conductive-brain/PCB/ORX_Lite_Receiver/docs/design_process.md

# Design process

How ORX-LITE was designed: from what it must do, to every value on the schematic.
Every number comes from `calc/design_calcs.py` (output in `calc/results.txt`), unless it says
"datasheet" or "choice". Each formula has its LibreOffice StarMath code under it.

## 1. What the board must do

| Need | Value | Source |
|---|---|---|
| Light input | one photodiode, 320 to 1060 nm | choice; S5971 datasheet |
| Signal speed | about 100 kHz | choice |
| Sampling | 12 bits, 1 million samples per second | choice |
| Interface | SPI, 3 wires, 3.3 V logic, to any microcontroller board | choice |
| Power | 5 V and 3.3 V from the microcontroller board | choice |
| Board | 4 layers, about 50 x 40 mm | choice |

## 2. The chain

```
light → photodiode → TIA → low-pass filter → R8 + C16 → ADC → J1 → microcontroller
        (current)    (voltage)  (clean voltage)            (numbers)
```

- The photodiode makes a current that follows the light.
- The TIA turns the current into a voltage.
- The filter removes everything faster than the ADC can handle.
- R8 and C16 feed the ADC's sampling capacitor.
- The ADC turns the voltage into numbers and sends them over SPI.

The full schematic is in
[release/rev-A/docs/ORX-LITE one-channel optical receiver.pdf](../release/rev-A/docs/ORX-LITE%20one-channel%20optical%20receiver.pdf).

## 3. Power

```
J1 5 V   → FB1 → +5V_F → U1 → +3V3_A   → op amps U3, U4
                       → U2 → +3V0_ADC → ADC supply and reference, VREF divider
                       → R2 → PD_K     → photodiode bias
J1 3.3 V → FB2 → +3V3_D → ADC digital side, LED, CS pull-up
```

**Why linear regulators.** A switching regulator makes ripple at its switching frequency, right
where our signal lives. A linear regulator makes no ripple; it only turns the extra voltage into heat.

**Why two regulators.** The ADC uses its supply as its reference, so it gets a quiet supply of its own.
This also keeps the ADC's current pulses off the op amps' supply.

**How much current we take from 5 V** (op amps 5 mA max each, datasheet; ADC 0.23 mA, datasheet;
VREF divider 3.0 V / 12 kΩ):

$$I_{5V} = 2 \cdot 5\,\text{mA} + 0.23\,\text{mA} + \frac{3.0\,\text{V}}{12\,\text{k}\Omega} = 10.5\,\text{mA}$$

```
I_{5V} = 2 cdot 5 " mA" + 0.23 " mA" + {3.0 " V"} over {12 " k" %OMEGA} = 10.5 " mA"
```

**How hot U1 gets.** Small, so no cooling needed:

$$P_{U1} = (5.0 - 3.3)\,\text{V} \times 10\,\text{mA} = 17\,\text{mW}$$

```
P_{U1} = (5.0 - 3.3) " V" times 10 " mA" = 17 " mW"
```

**LED current** (2.0 V green LED drop is an assumption):

$$I_{LED} = \frac{3.3\,\text{V} - 2.0\,\text{V}}{1\,\text{k}\Omega} = 1.3\,\text{mA}$$

```
I_{LED} = {3.3 " V" - 2.0 " V"} over {1 " k" %OMEGA} = 1.3 " mA"
```

## 4. Photodiode bias

A photodiode with a positive voltage on its cathode (reverse bias) is faster and more linear.
Our only voltage above 3.3 V is the 5 V from the host, so the cathode gets filtered 5 V.

$$f_{bias} = \frac{1}{2\pi R_2 C_7} = \frac{1}{2\pi \cdot 1\,\text{k}\Omega \cdot 10\,\mu\text{F}} = 16\,\text{Hz}$$

```
f_{bias} = 1 over {2 %pi R_2 C_7} = 1 over {2 %pi cdot 1 " k" %OMEGA cdot 10 " %mu F"} = 16 " Hz"
```

The anode sits at VREF_TIA = 2.5 V (section 5), so:

$$V_{bias} = 5.0\,\text{V} - 2.5\,\text{V} = 2.5\,\text{V}$$

```
V_{bias} = 5.0 " V" - 2.5 " V" = 2.5 " V"
```

At 2.5 V the S5971 has about 7.5 pF (read from the datasheet graph). At 10 V it would have 3 pF.
For a 100 kHz signal, 7.5 pF is fine.

## 5. TIA: current to voltage

The op amp keeps its − input at the same voltage as its + input (2.5 V). The photocurrent cannot
flow into the op amp's input (only 0.2 pA flows there, datasheet). So all of it flows through R3:

$$V_{TIA} = V_{REF} - I_{ph} \cdot R_3$$

```
V_{TIA} = V_{REF} - I_{ph} cdot R_3
```

Examples: no light gives 2.5 V. 10 µA gives 2.5 V − 10 µA × 100 kΩ = 1.5 V.

**The 2.5 V reference.** The output can only go down with light, so it starts high:

$$V_{REF} = 3.0\,\text{V} \cdot \frac{R_5}{R_4 + R_5} = 3.0\,\text{V} \cdot \frac{10\,\text{k}}{12\,\text{k}} = 2.5\,\text{V}$$

```
V_{REF} = 3.0 " V" cdot {R_5} over {R_4 + R_5} = 3.0 " V" cdot {10 " k"} over {12 " k"} = 2.5 " V"
```

It comes from +3V0_ADC, the ADC's own reference. If that rail is 2 % high, VREF and the ADC's range
are both 2 % high, and the dark reading stays the same (a "ratiometric" design).
C11 filters the reference:

$$f_{ref} = \frac{1}{2\pi \frac{R_4 R_5}{R_4 + R_5} C_{11}} = \frac{1}{2\pi \cdot 1.67\,\text{k}\Omega \cdot 10\,\mu\text{F}} = 9.5\,\text{Hz}$$

```
f_{ref} = 1 over {2 %pi {R_4 R_5} over {R_4 + R_5} C_{11}} = 1 over {2 %pi cdot 1.67 " k" %OMEGA cdot 10 " %mu F"} = 9.5 " Hz"
```

**Choosing R3 (the gain).** The output can go from 2.5 V down to about 0.05 V (the OPA365 gets
within 20 mV of its rail, datasheet; 0.05 V is our margin). R3 = 100 kΩ gives:

$$I_{FS} = \frac{V_{REF} - 0.05\,\text{V}}{R_3} = \frac{2.45\,\text{V}}{100\,\text{k}\Omega} = 24.5\,\mu\text{A}$$

```
I_{FS} = {V_{REF} - 0.05 " V"} over R_3 = {2.45 " V"} over {100 " k" %OMEGA} = 24.5 " %mu A"
```

$$P_{FS} = \frac{I_{FS}}{0.60\,\text{A/W}} = 41\,\mu\text{W at 830 nm}$$

```
P_{FS} = I_{FS} over {0.60 " A/W"} = 41 " %mu W"
```

A bigger R3 would see weaker light but would run out of range sooner and be slower.

**Choosing C10 (the speed).** C10 and R3 set the TIA's bandwidth:

$$f_p = \frac{1}{2\pi R_3 C_{10}} = \frac{1}{2\pi \cdot 100\,\text{k}\Omega \cdot 10\,\text{pF}} = 159\,\text{kHz}$$

```
f_p = 1 over {2 %pi R_3 C_{10}} = 1 over {2 %pi cdot 100 " k" %OMEGA cdot 10 " pF"} = 159 " kHz"
```

C10 also keeps the TIA stable. The capacitance at the − input (photodiode, op-amp input, pads)
can make the amplifier ring. That capacitance is:

$$C_{in} = C_d + C_{cm} + C_{diff} + C_{pcb} = 7.5 + 2 + 6 + 0.5 = 16\,\text{pF}$$

```
C_{in} = C_d + C_{cm} + C_{diff} + C_{pcb} = 7.5 + 2 + 6 + 0.5 = 16 " pF"
```

(op-amp input capacitance: datasheet; 0.5 pF for pads: assumption). The smallest C10 that keeps
the TIA stable is:

$$C_{10,min} = \sqrt{\frac{C_{in}}{2\pi R_3 \cdot GBW}} = \sqrt{\frac{16\,\text{pF}}{2\pi \cdot 100\,\text{k}\Omega \cdot 50\,\text{MHz}}} = 0.71\,\text{pF}$$

```
C_{10,min} = sqrt{ C_{in} over {2 %pi R_3 cdot GBW} } = sqrt{ {16 " pF"} over {2 %pi cdot 100 " k" %OMEGA cdot 50 " MHz"} } = 0.71 " pF"
```

10 pF is far above that: the phase margin is 84° (model; above 45° counts as stable). We use the
larger value on purpose: it limits the bandwidth to what we need, and less bandwidth means less noise.

## 6. Low-pass filter

The ADC samples 1 million times per second. Anything faster than half of that (500 kHz) folds back
and looks like a slow signal. This is called aliasing. The filter removes it before the ADC sees it.

The filter is a 2nd-order Sallen-Key with R6 = R7 = R:

$$f_0 = \frac{1}{2\pi R \sqrt{C_{13} C_{14}}} = \frac{1}{2\pi \cdot 4.99\,\text{k}\Omega \cdot \sqrt{220\,\text{pF} \cdot 100\,\text{pF}}} = 215\,\text{kHz}$$

```
f_0 = 1 over {2 %pi R sqrt{C_{13} C_{14}}} = 1 over {2 %pi cdot 4.99 " k" %OMEGA cdot sqrt{220 " pF" cdot 100 " pF"}} = 215 " kHz"
```

$$Q = \frac{1}{2}\sqrt{\frac{C_{13}}{C_{14}}} = \frac{1}{2}\sqrt{\frac{220}{100}} = 0.74$$

```
Q = 1 over 2 sqrt{ C_{13} over C_{14} } = 1 over 2 sqrt{ 220 over 100 } = 0.74
```

Q = 0.707 is the flattest response; 0.74 is within 0.04 dB of flat. We use E12 values (220 pF, 100 pF).

**The whole chain** (TIA, filter, R8 + C16) is flat up to 143 kHz (−3 dB). It is 25 dB down at
500 kHz and 40 dB down at 900 kHz, where signals would fold back into our band.

## 7. Feeding the ADC: R8 and C16

At each sample the ADC connects its 15 pF capacitor (datasheet) to the input. That capacitor takes
some charge and makes a small dip. C16 supplies the charge. The datasheet's rule:

$$C_{16} \ge 20 \cdot C_{sample} = 20 \cdot 15\,\text{pF} = 300\,\text{pF} \quad \Rightarrow \quad 1.5\,\text{nF}$$

```
C_{16} >= 20 cdot C_{sample} = 20 cdot 15 " pF" = 300 " pF"
```

R8 keeps U4 from ringing while it drives C16. The datasheet asks for an op amp fast enough:

$$GBW \ge \frac{4}{2\pi R_8 C_{16}} = \frac{4}{2\pi \cdot 22\,\Omega \cdot 1.5\,\text{nF}} = 19\,\text{MHz}$$

```
GBW >= 4 over {2 %pi R_8 C_{16}} = 4 over {2 %pi cdot 22 %OMEGA cdot 1.5 " nF"} = 19 " MHz"
```

The OPA365 has 50 MHz. TI's own example uses 25 Ω and 1.5 nF.

**Does the dip recover in time?** At 1 MSPS with a 16 MHz clock, the ADC converts for
12.5 clock periods plus 15 ns of setup (datasheet). The time left to take the next sample is:

$$t_{acq} = 1\,\mu\text{s} - (12.5 \cdot 62.5\,\text{ns} + 15\,\text{ns}) = 204\,\text{ns}$$

```
t_{acq} = 1 " %mu s" - (12.5 cdot 62.5 " ns" + 15 " ns") = 204 " ns"
```

The datasheet needs at least 200 ns, so 1 MSPS just fits. The worst dip and what is left of it after
200 ns (R8 × C16 = 33 ns):

$$\Delta V = 3.0\,\text{V} \cdot \frac{15\,\text{pF}}{15\,\text{pF} + 1.5\,\text{nF}} = 29.7\,\text{mV}, \qquad \Delta V \cdot e^{-200\,\text{ns}/33\,\text{ns}} = 69\,\mu\text{V}$$

```
%DELTA V = 3.0 " V" cdot {15 " pF"} over {15 " pF" + 1.5 " nF"} = 29.7 " mV" ~~~~ %DELTA V cdot e^{-200 " ns" / 33 " ns"} = 69 " %mu V"
```

69 µV is below half an LSB (366 µV). This simple estimate assumes U4's output is stiff.
The SPICE simulation (step 5, section 10) includes U4 and agrees: at 1.5 V the dip is 16.1 mV
and 28 µV is left after 200 ns.

## 8. ADC and SPI

- **Input:** AINM to GND, AINP to ADC_IN. The ADC reads 0 to 3.0 V as 0 to 4095.
- **One step (LSB):**

$$LSB = \frac{3.0\,\text{V}}{4096} = 732\,\mu\text{V}$$

```
LSB = {3.0 " V"} over 4096 = 732 " %mu V"
```

- **A frame:** CS goes low, the ADC needs 14 SCLK cycles: two zeros, then 12 data bits, MSB first.
  The first frame after power-up is an offset calibration: hold CS low for at least 16 SCLKs
  (datasheet).
- **33 Ω on SCLK, CS_N, SDO:** fast edges ring on the wires to the host. A small resistor at the end
  that drives each wire softens the edge.
- **R12, 10 kΩ pull-up on CS:** keeps the ADC idle until the host drives CS.
  Costs 0.33 mA while CS is low.

## 9. Noise: how small a light change we can see

The ADC's own noise follows from its SNR (70 dB at 3.0 V, datasheet):

$$v_{ADC} = \frac{3.0\,\text{V}}{2\sqrt{2}} \cdot 10^{-70/20} = 335\,\mu\text{V}_{rms}$$

```
v_{ADC} = {3.0 " V"} over {2 sqrt 2} cdot 10^{-70/20} = 335 " %mu V"_{rms}
```

The front end (R3's noise, op-amp noise, filter resistors) adds 22 µVrms at the ADC input (calc, integrated
to 1 GHz). R3's own noise density is:

$$e_{R3} = \sqrt{4 k T R_3} = 40.7\,\text{nV}/\sqrt{\text{Hz}}$$

```
e_{R3} = sqrt{4 k T R_3} = 40.7 " nV/" sqrt{"Hz"}
```

Noises add as a root sum of squares:

$$v_{tot} = \sqrt{v_{front}^2 + v_{ADC}^2} = \sqrt{22^2 + 335^2}\,\mu\text{V} = 336\,\mu\text{V}_{rms} = 0.46\,\text{LSB}$$

```
v_{tot} = sqrt{v_{front}^2 + v_{ADC}^2} = sqrt{22^2 + 335^2} " %mu V" = 336 " %mu V"_{rms}
```

The ADC sets the noise floor; the front end barely adds to it. Referred back to the light current:

$$i_{min} = \frac{v_{tot}}{R_3} = \frac{336\,\mu\text{V}}{100\,\text{k}\Omega} = 3.4\,\text{nA}_{rms}$$

```
i_{min} = v_{tot} over R_3 = {336 " %mu V"} over {100 " k" %OMEGA} = 3.4 " nA"_{rms}
```

## 10. Simulation results, and what is still to check

**SPICE (step 5).** `ORX_LITE_sim/` holds the front end (TIA with its reference, filter, R8 + C16)
with simulation-only sources, run in KiCad 9 (ngspice):
- the photodiode is a current source (10 µA DC, 10 µA AC) with 7.5 pF across it (S5971 datasheet);
- the supplies are ideal 3.3 V and 3.0 V sources;
- the ADC input is a 15 pF capacitor (ADS7042 datasheet) that a switch connects to ADC_IN for
  204 ns of every 1 µs; a second switch empties it in between, the worst case;
- the op amps use KiCad's built-in single-pole model with the OPA365's 50 MHz gain-bandwidth
  (datasheet). Its gain of 100k and output resistance of 10 Ω are round model values.

| Check | SPICE | Hand calculation (sections 5 to 7) |
|---|---|---|
| VREF_TIA | 2.500 V | 2.5 V |
| TIA_OUT at 10 µA of light | 1.500 V | 2.5 V − 10 µA × 100 kΩ = 1.5 V |
| TIA bandwidth (−3 dB) | 159 kHz | 159 kHz |
| Whole chain bandwidth (−3 dB) | 142 kHz | 143 kHz |
| Whole chain at 500 kHz | −25.1 dB | −25 dB |
| Whole chain at 900 kHz | −40.2 dB | −40 dB |
| Highest gain anywhere (peaking) | −0.0002 dB | none expected (Q = 0.74) |
| Sampling dip, ADC_IN at 1.5 V | 16.1 mV | 14.9 mV (29.7 mV scaled from 3.0 V to 1.5 V) |
| Dip left after 200 ns | 28 µV | must stay below half an LSB, 366 µV |

**The frequency response** (small-signal analysis in KiCad):

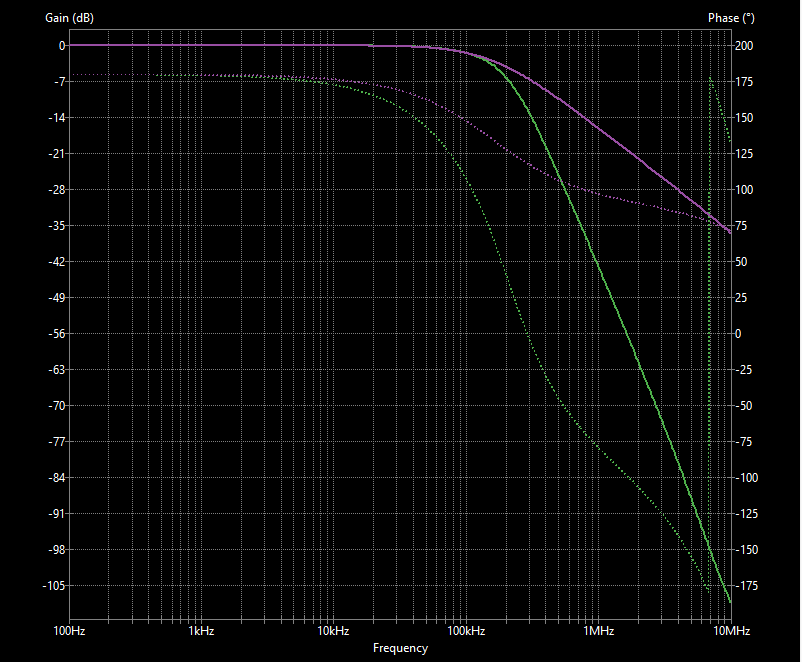
[picture p1: ORX_Lite_Receiver/docs/figures/sim_ac.png]
Gain and phase of TIA_OUT and ADC_IN from 100 Hz to 10 MHz


Purple is TIA_OUT, green is ADC_IN. Solid lines are the gain (left axis, dB), dotted lines the
phase (right axis, degrees). 0 dB is the full TIA gain: the 10 µA AC input × 100 kΩ = 1 V.
- The TIA alone (purple) is flat, 3 dB down at 159 kHz, then falls 20 dB per decade: one pole,
  from R3 and C10.
- The whole chain (green) stays within 0.4 dB up to 50 kHz, is 1.5 dB down at 100 kHz and 3 dB
  down at 142 kHz. Then it falls about 60 dB per decade: the TIA's pole plus the filter's two.
  At 500 kHz, half the sample rate, it is 25 dB down, so fast noise cannot fold back.
- The green line never rises above 0 dB: the filter does not ring.
- The phase starts at 180° because the TIA inverts: more light gives a lower voltage. The jump
  of the green phase near 7 MHz is only the plot wrapping from −180° to +180°.

**The ADC sampling** (transient analysis in KiCad, 20 µs):

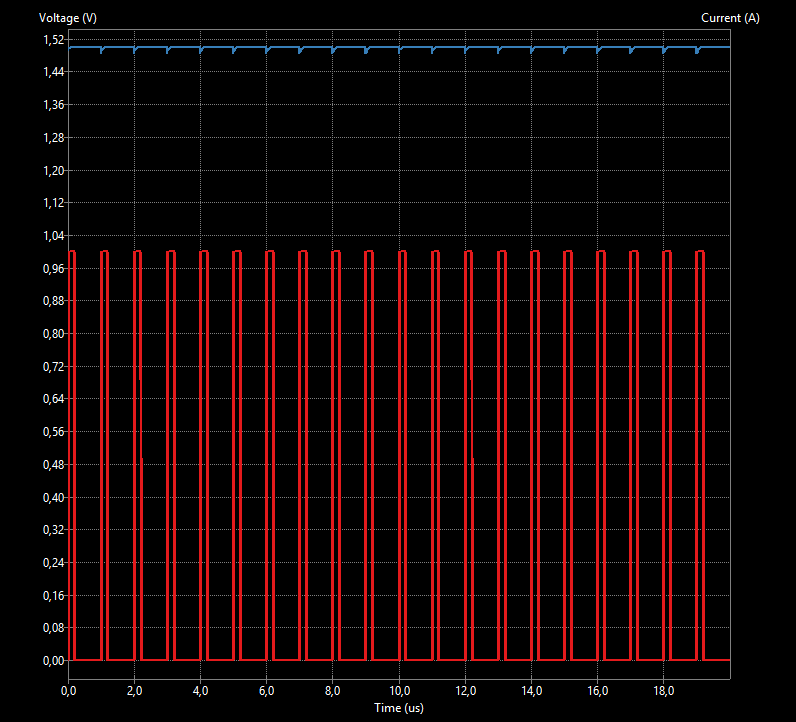
[picture p2: ORX_Lite_Receiver/docs/figures/sim_transient.png]
ACQ pulses and ADC_IN during 20 samples


Red is ACQ: high for 204 ns of every 1 µs, while the ADC's 15 pF is connected to ADC_IN. Blue is
ADC_IN at 1.5 V. At every sample the empty 15 pF takes charge from C16, so ADC_IN drops 16.1 mV
within 1 ns. U4 then refills C16 through R8: 3.3 mV are left after 50 ns, 0.7 mV after 100 ns and
28 µV after 200 ns, before the switch opens at 204 ns. All 20 samples look the same, so nothing
builds up from one sample to the next.

**Two problems on the way, and their fixes:**
- The two switches were first wired the wrong way round: the pulse went into the switch contacts
  and ADC_IN into the control input. The switch symbol has a control side (the "V" circle) and a
  contact side. The pulse drives the control side; the signal goes through the contacts.
- The first 20 µs run seemed to stop at 2.3 µs. Right after the second switch empties the 15 pF,
  the simulator takes steps of a few picoseconds, and with "Save all currents" ticked KiCad puts a
  current meter on every pin, which made the run about 80 times slower (measured). With only
  "Save all voltages" ticked the run finishes in seconds. The values are typed without a decimal
  point (500p, 20u), so the country setting of the PC cannot change them.

Still to check:
- Noise, with TI's own OPA365 model (the built-in model has no op-amp noise).
- The ADC's real sampling switch resistance (the simulation uses an ideal 1 Ω).
- Layout rules, from placement to routing (steps 7 and 8).
