conductive-brain/PCB/ORX_Lite_Receiver/release/rev-A/docs/ORX-LITE_3D_revA.png

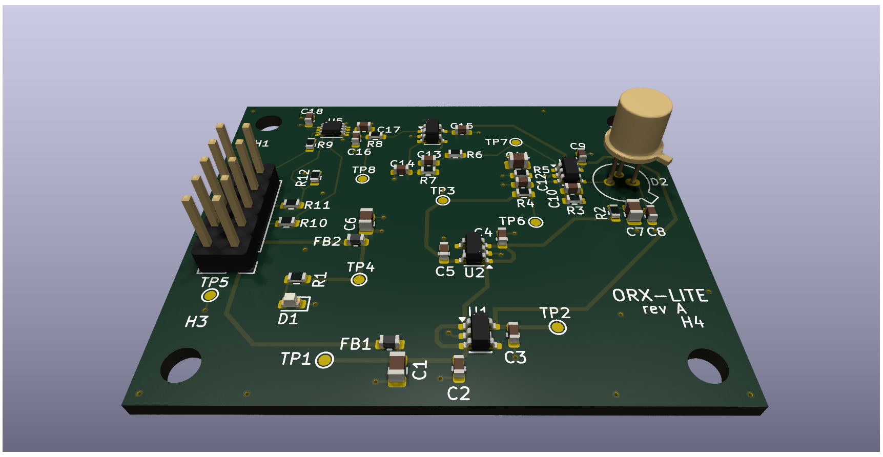
ORX_Lite_Receiver/release/rev-A/docs/ORX-LITE_3D_revA.png
