conductive-brain/PCB/ORX_Lite_Receiver/release/rev-A/assembly/ORX-LITE_BOM_revA.csv

Reference | Value | Datasheet | Footprint | Qty | DNP
C1,C6,C7,C11 | 10u | ~ | Capacitor_SMD:C_0805_2012Metric | 4
C2,C3,C4,C5,C17,C18 | 1u | ~ | Capacitor_SMD:C_0603_1608Metric | 6
C8,C9,C12,C15 | 100n | ~ | Capacitor_SMD:C_0603_1608Metric | 4
C10 | 10p | ~ | Capacitor_SMD:C_0603_1608Metric | 1
C13 | 220p | ~ | Capacitor_SMD:C_0603_1608Metric | 1
C14 | 100p | ~ | Capacitor_SMD:C_0603_1608Metric | 1
C16 | 1.5n | ~ | Capacitor_SMD:C_0603_1608Metric | 1
D1 | green | ~ | LED_SMD:LED_0603_1608Metric | 1
D2 | S5971 | https://www.hamamatsu.com/resources/pdf/ssd/s5971_etc_kpin1025e.pdf | Package_TO_SOT_THT:TO-18-3 | 1
FB1,FB2 | 220R@100MHz | ~ | Inductor_SMD:L_0603_1608Metric | 2
J1 | Conn_02x05_Odd_Even | ~ | Connector_PinHeader_2.54mm:PinHeader_2x05_P2.54mm_Vertical | 1
R1,R2 | 1k | ~ | Resistor_SMD:R_0603_1608Metric | 2
R3 | 100k | ~ | Resistor_SMD:R_0603_1608Metric | 1
R4 | 2k | ~ | Resistor_SMD:R_0603_1608Metric | 1
R5,R12 | 10k | ~ | Resistor_SMD:R_0603_1608Metric | 2
R6,R7 | 4.99k | ~ | Resistor_SMD:R_0603_1608Metric | 2
R8 | 22 | ~ | Resistor_SMD:R_0603_1608Metric | 1
R9,R10,R11 | 33 | ~ | Resistor_SMD:R_0603_1608Metric | 3
U1 | LP5907MFX-3.3 | http://www.ti.com/lit/ds/symlink/lp5907.pdf | Package_TO_SOT_SMD:SOT-23-5 | 1
U2 | LP5907MFX-3.0 | http://www.ti.com/lit/ds/symlink/lp5907.pdf | Package_TO_SOT_SMD:SOT-23-5 | 1
U3,U4 | OPA365xxDBV | https://www.ti.com/lit/ds/symlink/opa365.pdf | Package_TO_SOT_SMD:SOT-23-5 | 2
U5 | ADS7042xDCU | http://www.ti.com/lit/ds/symlink/ads7042.pdf | Package_SO:VSSOP-8_2.3x2mm_P0.5mm | 1
