conductive-brain/PCB/ORX_Lite_Receiver/calc/results.txt

== Power
5 V current, max                          10.48 mA      2 op amps + ADC AVDD + VREF divider
U1 heat                                      17 mW      (5 - 3.3) V x 10 mA
U2 heat                                    0.96 mW      (5 - 3.0) V x U2 load
LED current                                 1.3 mA      (3.3 - 2.0) V / R1
R12 current when CS is low                 0.33 mA      3.3 V / R12

== Photodiode bias
Bias filter corner                        15.92 Hz      1/(2 pi R2 C7)
Reverse bias                                2.5 V       5 V - VREF_TIA

== TIA
VREF_TIA                                    2.5 V       3.0 V x R5/(R4+R5)
Gain                                        0.1 V/uA    R3
Full-scale photocurrent                    24.5 uA      (VREF - 0.05 V)/R3
Full-scale light at 830 nm                40.83 uW      I / 0.60 A/W
TIA pole                                  159.2 kHz     1/(2 pi R3 C10)
Input capacitance                            16 pF      Cd + Ccm + Cdiff + Cpcb
Noise gain at high f                        2.6 V/V     1 + Cin/C10
Smallest stable C10                      0.7136 pF      sqrt(Cin/(2 pi R3 GBW))
VREF filter corner                        9.549 Hz      1/(2 pi (R4||R5) C11)
Loop crossover                            19.14 MHz     model GBW/s with a 200 MHz pole
Phase margin                              84.24 deg     > 45 deg = stable

== Sallen-Key filter and ADC input
Filter corner f0                            215 kHz     1/(2 pi R sqrt(C13 C14))
Filter Q                                 0.7416         0.707 = flattest
Chain -3 dB                               142.7 kHz     TIA x filter x RC
Chain gain at 500 kHz                    -25.03 dB      
Chain gain at 900 kHz                    -40.13 dB      
RC corner (R8, C16)                       4.823 MHz     1/(2 pi R8 C16)
C16 minimum (datasheet rule)                300 pF      20 x 15 pF
Op-amp GBW needed                         19.29 MHz     4/(2 pi R8 C16); OPA365 has 50
Conversion time at 16 MHz                 796.2 ns      12.5 SCLK periods + 15 ns setup
Acquisition time at 1 MSPS                203.7 ns      1 us - conversion; datasheet minimum 200 ns
RC time constant                             33 ns      R8 x C16
Worst sampling dip                         29.7 mV      3.0 V x 15 pF / (15 pF + 1.5 nF)
Dip left after 200 ns                      69.3 uV      must be < half an LSB

== Noise
LSB                                       732.4 uV      3.0 V / 4096
R3 noise density                           40.7 nV/rtHz sqrt(4 k T R3)
Front-end noise at the ADC                21.51 uVrms   integrated to 1 GHz
ADC noise                                 335.4 uVrms   from SNR 70 dB
Total noise                               336.1 uVrms   sqrt(front end^2 + ADC^2)
Total noise in LSB                       0.4589 LSB     
Smallest light change seen                3.361 nArms   total noise / R3
