conductive-brain/PCB/ORX_Lite_Receiver/release/rev-A/docs/ORX-LITE one-channel optical receiver-F_Fab.pdf

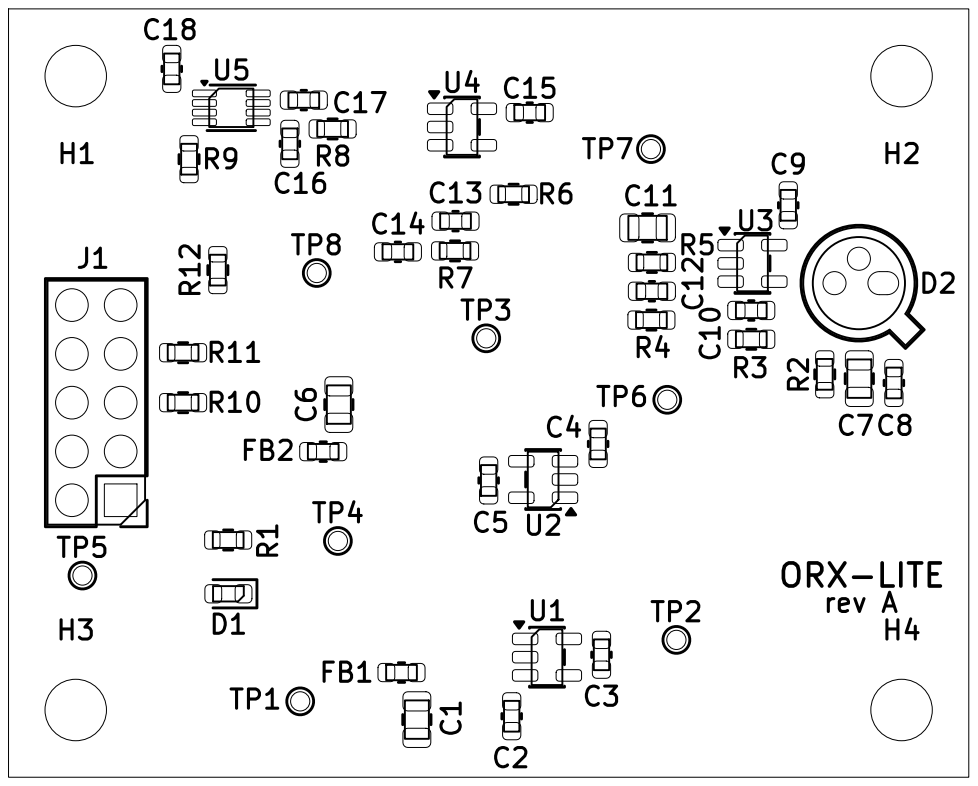
[picture p4: page 1]
