conductive-brain/PCB/ORX_Lite_Receiver/release/rev-A/docs/ORX-LITE one-channel optical receiver.pdf

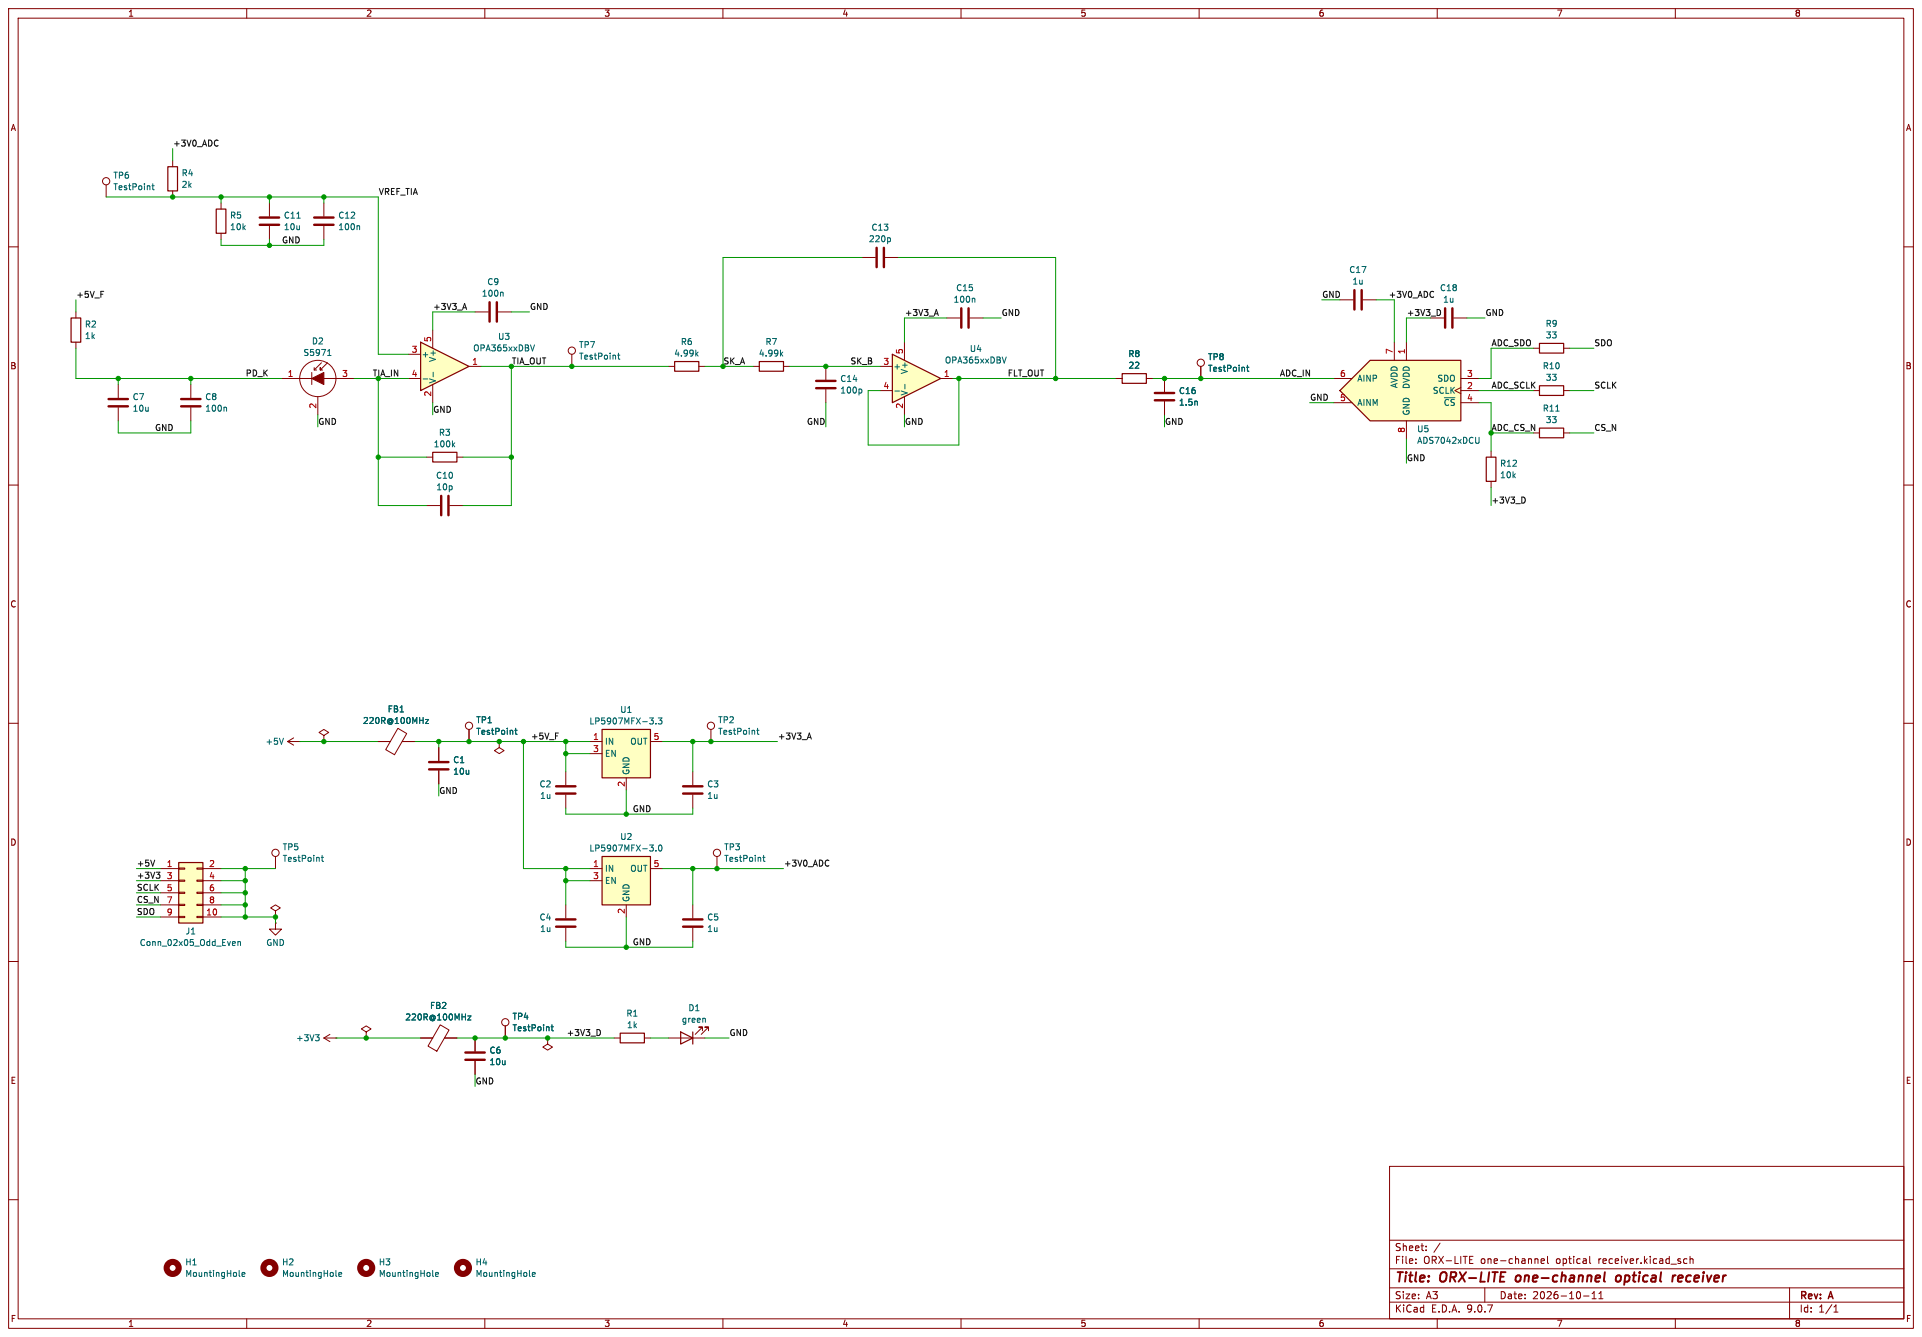
[picture p5: page 1]
