conductive-brain/PCB/ORX_Lite_Receiver/hardware/ORX-LITE one-channel optical receiver/ORX-LITE one-channel optical receiver.kicad_pcb

## KiCad design ORX_Lite_Receiver/hardware/ORX-LITE one-channel optical receiver/ORX-LITE one-channel optical receiver.kicad_pcb (2026-10-16)

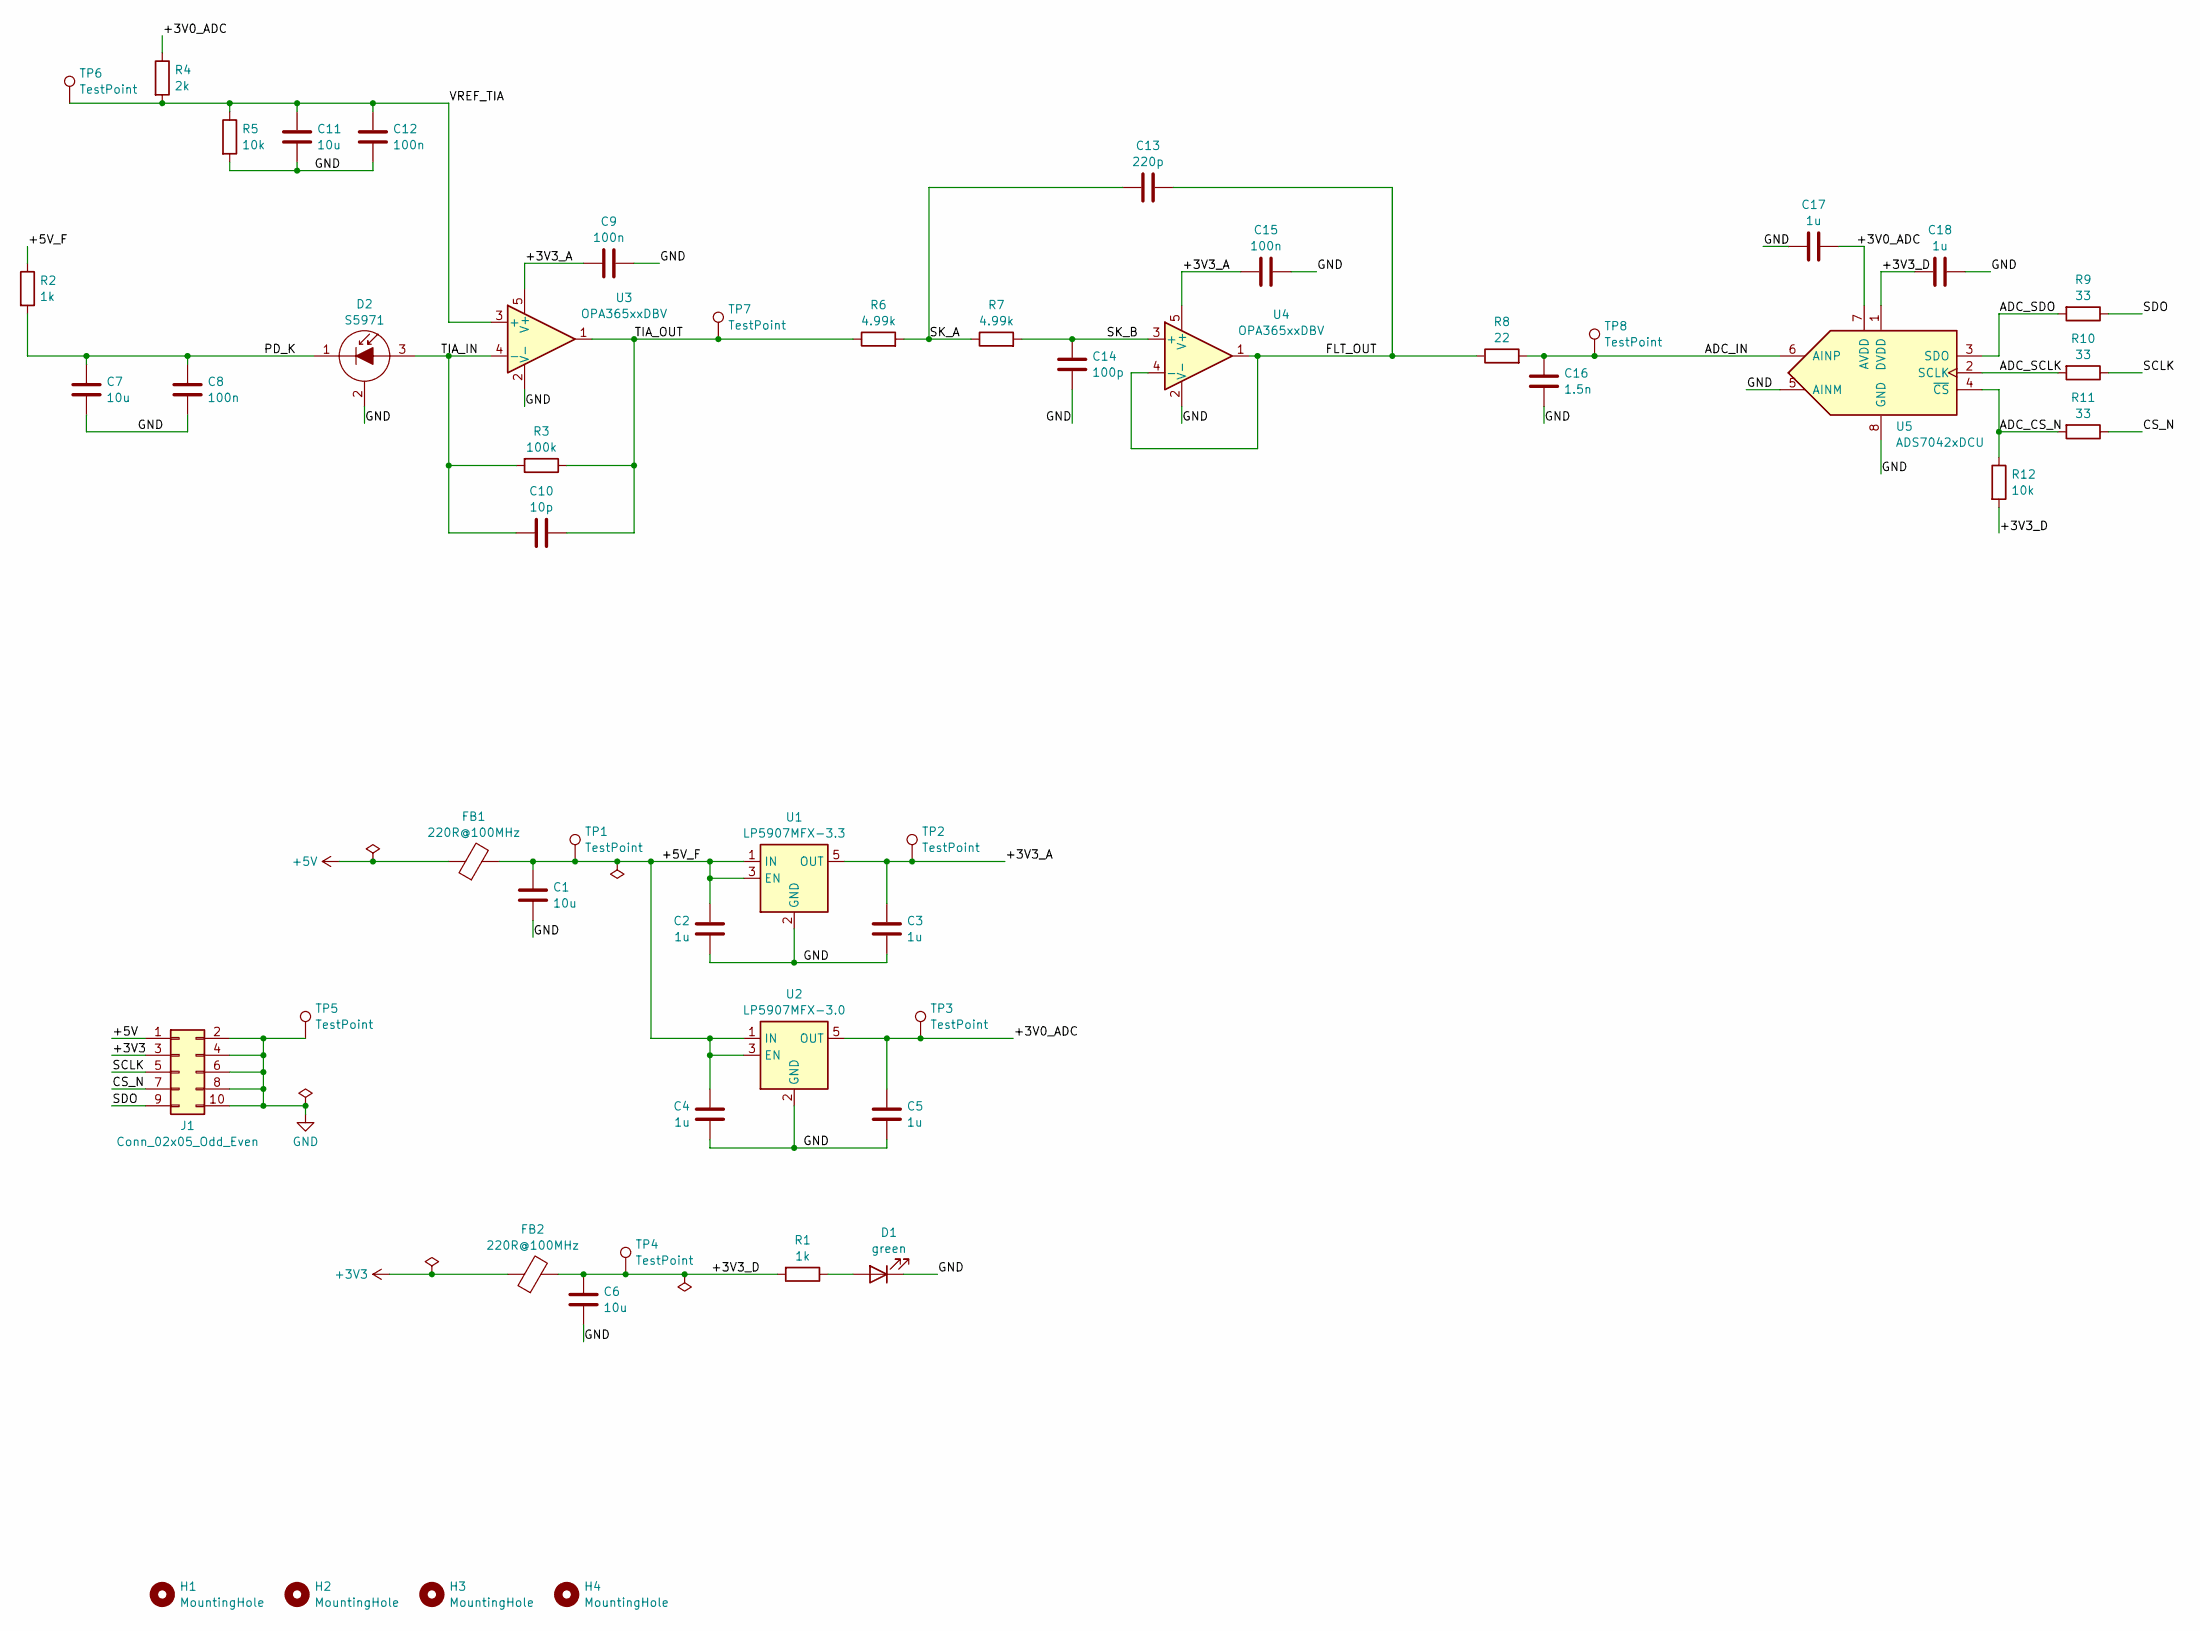
[picture p6: schematic ORX-LITE one-channel optical receiver.kicad_sch]

Parts:
C1, C6, C7, C11: 10u; C_0805_2012Metric
C2, C3, C4, C5, C17, C18: 1u; C_0603_1608Metric
C8, C9, C12, C15: 100n; C_0603_1608Metric
C10: 10p; C_0603_1608Metric
C13: 220p; C_0603_1608Metric
C14: 100p; C_0603_1608Metric
C16: 1.5n; C_0603_1608Metric
D1: green; LED_0603_1608Metric
D2: S5971; TO-18-3
FB1, FB2: 220R@100MHz; L_0603_1608Metric
H1, H2, H3, H4: MountingHole; MountingHole_3.2mm_M3
J1: Conn_02x05_Odd_Even; PinHeader_2x05_P2.54mm_Vertical
R1, R2: 1k; R_0603_1608Metric
R3: 100k; R_0603_1608Metric
R4: 2k; R_0603_1608Metric
R5, R12: 10k; R_0603_1608Metric
R6, R7: 4.99k; R_0603_1608Metric
R8: 22; R_0603_1608Metric
R9, R10, R11: 33; R_0603_1608Metric
TP1, TP2, TP3, TP4, TP5, TP6, TP7, TP8: TestPoint; TestPoint_Pad_D1.0mm
U1: LP5907MFX-3.3; SOT-23-5
U2: LP5907MFX-3.0; SOT-23-5
U3, U4: OPA365xxDBV; SOT-23-5
U5: ADS7042xDCU; VSSOP-8_2.3x2mm_P0.5mm

Connections:
+3V3: FB2.1, J1.3
+5V: FB1.1, J1.1
/+3V0_ADC: C5.1, C17.2, R4.1, TP3.1, U2.5 (OUT), U5.7 (AVDD)
/+3V3_A: C3.1, C9.1, C15.1, TP2.1, U1.5 (OUT), U3.5 (V+), U4.5 (V+)
/+3V3_D: C6.1, C18.2, FB2.2, R1.2, R12.2, TP4.1, U5.1 (DVDD)
/+5V_F: C1.1, C2.1, C4.1, FB1.2, R2.1, TP1.1, U1.1 (IN), U1.3 (EN), U2.1 (IN), U2.3 (EN)
/ADC_CS_N: R11.2, R12.1, U5.4 (~CS)
/ADC_IN: C16.1, R8.2, TP8.1, U5.6 (AINP)
/ADC_SCLK: R10.2, U5.2 (SCLK)
/ADC_SDO: R9.2, U5.3 (SDO)
/CS_N: J1.7, R11.1
/FLT_OUT: C13.1, R8.1, U4.1, U4.4 (-)
/PD_K: C7.1, C8.1, D2.1 (K), R2.2
/SCLK: J1.5, R10.1
/SDO: J1.9, R9.1
/SK_A: C13.2, R6.2, R7.1
/SK_B: C14.2, R7.2, U4.3 (+)
/TIA_IN: C10.2, D2.3 (A), R3.2, U3.4 (-)
/TIA_OUT: C10.1, R3.1, R6.1, TP7.1, U3.1
/VREF_TIA: C11.1, C12.1, R4.2, R5.1, TP6.1, U3.3 (+)
GND: C1.2, C2.2, C3.2, C4.2, C5.2, C6.2, C7.2, C8.2, C9.2, C11.2, C12.2, C14.1, C15.2, C16.2, C17.1, C18.1, D1.1 (K), D2.2 (C), J1.2, J1.4, J1.6, J1.8, J1.10, R5.2, TP5.1, U1.2 (GND), U2.2 (GND), U3.2 (V-), U4.2 (V-), U5.5 (AINM), U5.8 (GND)
unnamed: D1.2 (A), R1.1

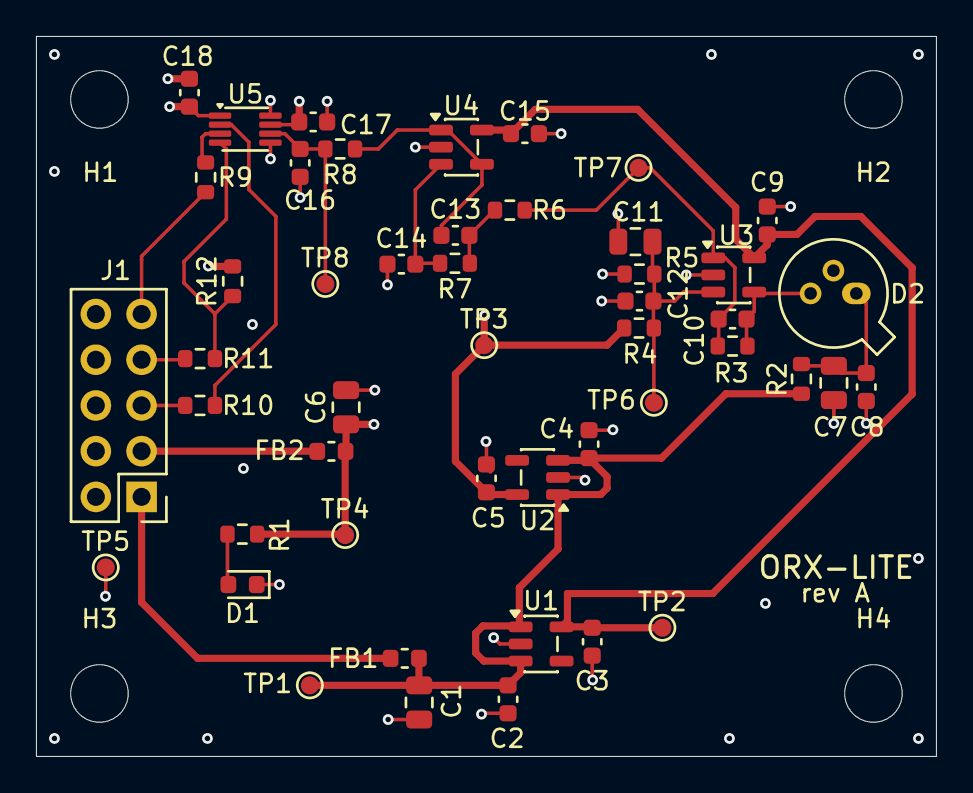
[picture p7: board ORX-LITE one-channel optical receiver.kicad_pcb from above]

Board: 4 copper layers, 50.0 x 40.0 mm, 52 parts (0 on the bottom side), 22 nets.
