conductive-brain/PCB/(commit log)

2026-10-11 Start the ORX-LITE repository
    A one-channel optical receiver: photodiode, two op amps, a 12-bit SPI ADC,
    4 layers. The README lists the plan: one commit per design step.
    .gitignore keeps KiCad's backups, autosaves and lock files out.
2026-10-11 Add the design process and the calculations behind it
    docs/design_process.md walks from what the board must do to every value,
    with each formula in LaTeX and in LibreOffice StarMath.
    calc/design_calcs.py computes every number in it (calc/results.txt).
2026-10-11 Create the KiCad project and set up the page
    KiCad 9 project in hardware/. The schematic uses an A3 page with the title
    "ORX-LITE one-channel optical receiver", revision A, dated 2026-10-11.
    Backups, lock files and local view settings stay out of git (.gitignore).
    [ORX-LITE one-channel optical receiver.kicad_pcb, ORX-LITE one-channel optical receiver.kicad_sch]
2026-10-11 Add power input, regulators, LED and test points
    J1 brings host 5 V and 3.3 V in. FB1 and FB2 (220 ohm at 100 MHz) with C1
    and C6 (10 uF) filter them into +5V_F and +3V3_D. U1 (LP5907-3.3) makes
    +3V3_A for the op amps and U2 (LP5907-3.0) makes +3V0_ADC for the ADC,
    each with 1 uF on input and output. D1 with R1 (1 kohm) shows +3V3_D is on.
    TP1 to TP5 give probe points on every rail and on GND.
    The schematic checker passes for all 18 parts. ERC reports only the SCLK,
    CS_N and SDO labels on J1, which connect in the ADC step.
    [ORX-LITE one-channel optical receiver.kicad_sch]
2026-10-11 Use the 9-step plan: one step per circuit block
    The board is drawn in 9 steps, one per block: project, power section,
    front end, ADC and host connector, checks, board setup, placement,
    routing, release files. Step references in the docs and the checker
    follow the new numbers.
2026-10-11 Add the front end: photodiode, TIA, reference and filter
    R2 (1 kohm) with C7 (10 uF) and C8 (100 nF) gives the S5971 photodiode a
    clean bias on its cathode (PD_K). U3 (OPA365) is the TIA: R3 (100 kohm) and
    C10 (10 pF) in its feedback turn the photocurrent into a voltage around
    VREF_TIA. R4 (2 kohm) and R5 (10 kohm) make VREF_TIA = 2.5 V from +3V0_ADC,
    held by C11 and C12. U4 (OPA365) is a unity-gain Sallen-Key low-pass with
    R6 = R7 = 4.99 kohm, C13 = 220 pF and C14 = 100 pF. R8 (22 ohm) and C16
    (1.5 nF) feed the ADC input and supply the charge for its sampling cap.
    C9 and C15 decouple the op amps. TP6, TP7 and TP8 probe VREF_TIA, TIA_OUT
    and ADC_IN. The schematic checker passes for all 41 pa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
    [ORX-LITE one-channel optical receiver.kicad_sch]
2026-10-11 Add the ADC, the SPI lines and the mounting holes
    U5 (ADS7042) samples ADC_IN on AINP with AINM on GND. AVDD runs from
    +3V0_ADC, which is also its reference, and DVDD from +3V3_D, each with
    1 uF (C17, C18). R10 and R11 (33 ohm) sit in SCLK and CS_N from the host,
    R9 (33 ohm) in SDO from the ADC, to soften fast edges. R12 (10 kohm) holds
    CS_N high while the host is not driving it. A PWR_FLAG on +3V3_D marks FB2
    as its source. H1 to H4 are the M3 mounting holes.
    The schematic is complete: the checker passes for all 52 parts and ERC
    reports no errors or warnings.
    [ORX-LITE one-channel optical receiver.kicad_sch]
2026-10-11 Arrange the schematic by block: power, front end, ADC
    The power section moves to the left of the page, the front end to the
    middle and the ADC to the right, so the blocks follow the signal from
    left to right. No connection changed: the checker passes for all 52
    parts and ERC reports nothing.
    [ORX-LITE one-channel optical receiver.kicad_sch]
2026-10-11 Line up the front end in signal order
    The bias, the photodiode with the TIA, the filter and the ADC now sit
    from left to right in the order the signal passes through them. The TIA
    reference sits next to U3 and the mounting holes move to the bottom.
    No connection changed: the checker passes for all 52 parts and ERC
    reports nothing.
    [ORX-LITE one-channel optical receiver.kicad_sch]
2026-10-12 Add pictures of the signal path and the schematic page
    docs/figures/signal_path_reference.png draws the whole circuit in the order
    the signal travels, with the signal, the SPI control lines and the power
    marked by arrows. It was built from the hardware schematic: the KiCad
    netlists match part for part, net for net and pin for pin, and ERC is clean.
    docs/figures/schematic_block_map.png marks every block on the hardware
    schematic page and the order the signal visits them.
    design_process.md shows the first picture in "The chain".
2026-10-12 Redraw the schematic page in signal order
    The page now reads left to right like the reference picture: photodiode
    bias, photodiode, TIA with its 2.5 V reference, filter, ADC input filter,
    ADC and SPI resistors on top, power below. The PWR_FLAGs moved next to the
    ferrite beads; the old flag at U5 DVDD is removed, so +3V3_D has one flag
    again. R7 is turned so its pins sit on the same nets as before.
    Every connection is unchanged: the netlist matches the previous commit
    net for net and pin for pin, the checker passes and ERC is clean.
    docs/figures/schematic_block_map.png now maps the new page.
    [ORX-LITE one-channel optical receiver.kicad_sch]
2026-10-12 Keep the schematic exactly as drawn
    This puts back the file as drawn by hand: the extra PWR_FLAG at U5 DVDD
    is removed, so +3V3_D has one flag next to FB2, and R7 stays as drawn
    (a resistor has no polarity; turning it only swaps its pin numbers).
    It replaces the edits made to the file in the previous commit, which
    also left stray line endings.
    The checker passes, ERC is clean, and every net holds the same parts.
    [ORX-LITE one-channel optical receiver.kicad_sch]
2026-10-12 Place part text closer and hide the PWR_FLAG names
    References and values now sit right next to each part (autoplace without
    snapping to the 50 mil grid), and the five PWR_FLAGs no longer show their
    name. Only text moved: no part or wire changed, the netlist is identical,
    the checker passes and ERC is clean.
    [ORX-LITE one-channel optical receiver.kicad_sch]
2026-10-12 Assign footprints to every part
    All 52 parts now have a footprint, chosen from the real part's size in
    docs/components.md: 0603 for resistors, ferrite beads, the LED and most
    capacitors, 0805 for the four 10 uF capacitors (they keep more of their
    capacitance under DC voltage), SOT-23-5 for U1 to U4, VSSOP-8 for U5,
    TO-18 for the photodiode, a 2x5 2.54 mm header for J1, 1 mm test pads
    and M3 holes. Every symbol pin has a pad with the same number, the
    checker with footprints passes and ERC is clean.
    [ORX-LITE one-channel optical receiver.kicad_sch]
2026-10-12 Add the SPICE simulation of the front end
    ORX_LITE_sim/ is a separate KiCad project with the TIA, its reference, the
    Sallen-Key filter and R8 + C16, plus simulation-only sources: a current
    source with 7.5 pF for the photodiode, ideal supplies, and a switched
    15 pF for the ADC input (204 ns of every 1 us, emptied in between). The op
    amps use KiCad's built-in model with the OPA365's 50 MHz gain-bandwidth.
    The results match the hand calculations: TIA_OUT 1.5 V at 10 uA, chain
    -3 dB at 142 kHz, -25 dB at 500 kHz, and 28 uV of sampling dip left after
    200 ns. design_process.md lists them; Step 5 is done.
    [ORX_LITE_sim.kicad_pcb, ORX_LITE_sim.kicad_sch]
2026-10-12 Add the simulation plots and explain them in the design notes
    design_process.md section 10 now shows the two KiCad plots: the frequency
    response of TIA_OUT and ADC_IN, and 20 ADC samples at ADC_IN. It explains
    how to read them and the two problems met on the way: the switches wired
    the wrong way round, and a run slowed down by saving every current.
2026-10-12 Save the simulator tabs of the front-end simulation
    ORX_LITE_sim.wbk keeps the three analyses (operating point, AC from
    100 Hz to 10 MHz, transient over 20 us) with their settings, so they
    reopen as they were. The project file now points to it.
2026-10-12 Set up the 4-layer board: stackup, layers, rules and net classes
    The board is 1.6 mm with 4 copper layers on KiCad's default stackup
    (0.1 mm prepreg between the top copper and the first inner layer).
    In1.Cu is GND, a solid plane right under the parts, so every top track
    has its return path 0.1 mm below it; In2.Cu is PWR for the supplies.
    Rules are generous, easy-to-make values: 0.15 mm clearance and track,
    0.6 mm vias with 0.3 mm holes, 0.3 mm copper to edge. Signals route at
    0.2 mm (Default class); the six supply nets are in the Power class at
    0.4 mm and 0.2 mm clearance. The 50 x 40 mm outline comes next.
    [ORX-LITE one-channel optical receiver.kicad_pcb]
2026-10-13 Draw the 50 x 40 mm board outline
    The board edge is one rectangle on Edge.Cuts from (100, 100) to
    (150, 140) mm, the size planned in design_process.md. It tells KiCad
    and the factory where the board ends, and DRC now keeps copper 0.3 mm
    away from it. DRC is clean. Step 6 is done.
    [ORX-LITE one-channel optical receiver.kicad_pcb]
2026-10-14 Place all 52 parts on the board
    The signal runs in one line from right to left: the photodiode D2 at the
    right edge, then the TIA, the filter and the ADC, with J1 at the left edge.
    Power sits in the lower half, away from the sensitive front end, and the
    M3 holes are in the corners. The parts that matter are placed by their
    connections: D2 to U3 (the TIA input) is 3.1 mm pad to pad, each chip's
    small capacitor sits 1.5 to 1.8 mm from its supply pin, R8 and C16 sit at
    the ADC input, R9 at the ADC (it drives SDO) and R10, R11 at J1 (the host
    drives SCLK and CS_N). Labels are 0.8 mm and none sits on a pad or on
    another label. DRC is clean and the board matches the schematic.
    [ORX-LITE one-channel optical receiver.kicad_pcb]
2026-10-14 Lower the Power net class clearance to 0.15 mm
    The ADS7042's pads are 0.15 mm apart (0.5 mm pitch, 0.35 mm pads in
    KiCad's VSSOP-8 footprint), so a 0.2 mm clearance on its supply pins
    could never be met and DRC reported three errors at U5. Power tracks
    keep their 0.4 mm width; only the gap rule now matches the Default class.
2026-10-15 Route the ground layer, ground vias and top-layer supply tracks
    Step 8 checkpoint. In1 is one solid GND zone over the whole board, so
    every track on top has its return path 0.1 mm below it. Each of the 25
    SMD ground pads has its own short track and via down to that sheet.
    The supplies are drawn on the top layer at 0.4 mm: +5V and +3V3 from J1
    to the ferrite beads, +5V_F to both regulators and the photodiode bias,
    +3V3_A from U1 to the two op amps along free board space, +3V0_ADC from
    U2 to C5, TP3 and the reference divider, and +3V3_D from FB2 to C6, TP4
    and the LED. At U5 the two supply stubs are 0.2 mm, because its pins are
    only 0.15 mm apart (a 0.2 mm track size was added to the project)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
    [ORX-LITE one-channel optical receiver.kicad_pcb]
2026-10-15 Connect the ADC supplies through the inner power layer
    U5 sits in the top-left corner, far from its two supplies, and the top
    layer between them is needed for the filter-to-ADC and SPI tracks. So
    both supplies go down a via, run on In2 at 0.4 mm and come back up next
    to U5: +3V0_ADC from TP3 to C17, and +3V3_D from C6 through R12 to C18.
    The +3V3_D run passes under C6 on In2, which made it 4 mm shorter.
    Five supply vias do this. Unlike a GND via, each one passes through a
    small hole in the GND sheet and only connects to its own In2 track.
    The LED pair moved once more so R1 sits on the TP4 track, and TP8 moved
    down 1.5 mm.
    All supplies are now connected. DRC: 0 errors, 0 warnings, board mat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
    [ORX-LITE one-channel optical receiver.kicad_pcb]
2026-10-15 Route the analog signal path from the photodiode to the ADC input
    All eight analog nets are now drawn on the top layer at 0.2 mm, with no
    vias, so every track sits right over the GND sheet and keeps a small
    loop. TIA_IN, the node that carries the raw photodiode current, is a
    straight 3.1 mm line from D2 to U3, and the R3/C10 feedback pair sits
    right below U3.
    Two tracks run between the pin rows of an op amp because the pins they
    join are on opposite sides: TIA_OUT under U3 (to C10 and R3) and
    FLT_OUT under U4 (the buffer's output back to its input). TP6, TP7 and
    TP8 moved onto their tracks, so the test points need no side branches.
    The filter's middle node (SK_A) is 3.6 mm long.
    DRC: 0 err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
    [ORX-LITE one-channel optical receiver.kicad_pcb]
2026-10-15 Route the SPI lines and the LED: every connection is drawn
    SCLK, CS_N and SDO run on the top layer at 0.2 mm on the left side of the
    board, away from the analog path. Each line has its 33 ohm resistor at
    the chip that drives it: R10 and R11 at J1 (the host drives SCLK and
    CS_N) and R9 at U5 (the ADC drives SDO).
    U5's digital pins and J1's pins come in a different order, so SCLK leaves
    pin 2 through the gap between U5's two pin rows and turns right around
    pin 5's GND via, while CS_N goes down and passes R12 on the left. That
    keeps the clock 0.475 mm from the ADC's analog pins and 0.8 mm from CS_N;
    the first version ran both 0.15 mm apart for 6 mm. R1 to D1 closes the
    LED.
    DRC: 0 errors, 0 w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
    [ORX-LITE one-channel optical receiver.kicad_pcb]
2026-10-16 Fill In2 and the bottom with ground and stitch the ground layers
    The space In2 does not need for its two supply tracks, and the whole
    bottom layer, are now GND copper (0.3 mm gap to other nets). The supply
    tracks on In2 sit between ground on every side, the three GND layers act
    as one thick ground, and the copper is spread evenly so the board stays
    flat. The top layer stays without a fill: it carries the sensitive analog
    tracks and already has the solid GND sheet 0.1 mm below.
    Twelve stitching vias along the edges and in the empty areas tie the GND
    layers together. Before them, the bottom-right corner was 18 mm from the
    nearest link between the layers; now no spot is more than 7 mm away.
    S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
    [ORX-LITE one-channel optical receiver.kicad_pcb]
2026-10-16 Tidy the labels and print the board name and revision
    Step 9 starts with the silkscreen. The H1 and H2 labels sat above the
    board edge, where the factory would cut them off; they now sit inside,
    below their holes, like H3 and H4. The J1 label moved above the header
    because it ran into TP5's label ("TP5J1").
    "ORX-LITE" and "rev A" are printed in the free bottom-right corner, clear
    of tracks, vias and labels, so a board in the hand can be matched to its
    files. DRC: 0 errors, 0 warnings, 0 unconnected.
    [ORX-LITE one-channel optical receiver.kicad_pcb]
2026-10-16 Add the revision A fabrication files: Gerbers and drill files
    release/rev-A/gerbers holds what a board house needs to make the bare
    board: one Gerber per layer (F.Cu, GND, PWR, B.Cu, both solder masks,
    top silkscreen, top paste, Edge.Cuts) in the X2 format with netlist
    attributes, the Gerber job file with the 4-layer 1.6 mm stackup, and
    separate Excellon files for plated and non-plated holes with PDF maps.
    Checked: the outline is 50 x 40 mm; the plated file has 42 x 0.3 mm vias,
    3 x 0.7 mm (D2) and 10 x 1.0 mm (J1), the non-plated file 4 x 3.2 mm
    mounting holes. KiCad saved the plot settings (output folder, Protel
    extensions, silkscreen clipped at the mask) in the board and project.
    releas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
    [ORX-LITE one-channel optical receiver-B_Cu.gbl, ORX-LITE one-channel optical receiver-B_Mask.gbs, ORX-LITE one-channel optical receiver-Edge_Cuts.gm1, ORX-LITE one-channel optical receiver-F_Cu.gtl, ORX-LITE one-channel optical receiver-F_Mask.gts, ORX-LITE one-channel optical receiver-F_Paste.gtp, ORX-LITE one-channel optical receiver-F_Silkscreen.gto, ORX-LITE one-channel optical receiver-NPTH.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]
2026-10-16 Add the revision A parts list and placement file
    release/rev-A/assembly holds what an assembler needs besides the bare
    board: the parts list (BOM), grouped by value and footprint, and the
    placement file with each part's X, Y, rotation and side.
    Both list the same 40 parts: 38 surface-mount parts plus the photodiode
    D2 and the header J1, all on the top side. The eight test points are bare
    copper pads with nothing to buy or place, so they are now excluded from
    the BOM in the schematic and, after the board update, on the board too;
    the mounting holes already were. The project file keeps the BOM export
    settings, so the next export gives the same file.
    DRC: 0 errors, 0 unconnected, board matche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
    [ORX-LITE one-channel optical receiver.kicad_pcb, ORX-LITE one-channel optical receiver.kicad_sch, ORX-LITE_BOM_revA.csv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]
2026-10-16 Raise the labels to the factory's minimum size and plot the Gerbers again
    JLCPCB's capability page asks for silkscreen text at least 1.0 mm high,
    lines at least 0.15 mm thick, and 0.15 mm between a label and a pad;
    thinner or smaller print can come out unreadable. The labels were 0.8 mm
    high with 0.12 mm lines, and the library part outlines 0.12 mm.
    All reference labels and "rev A" are now 1.0 mm high with 0.15 mm lines,
    all part outlines 0.15 mm. The bigger labels collided in a few places, so
    the crowded ones moved: every label is now at least 0.15 mm from every
    other label and at least 0.16 mm from every pad (measured on the board),
    and no two labels run together ("TP1FB1", "C7C8" before)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
    [ORX-LITE one-channel optical receiver-B_Cu.gbl, ORX-LITE one-channel optical receiver-B_Mask.gbs, ORX-LITE one-channel optical receiver-Edge_Cuts.gm1, ORX-LITE one-channel optical receiver-F_Cu.gtl, ORX-LITE one-channel optical receiver-F_Mask.gts, ORX-LITE one-channel optical receiver-F_Paste.gtp, ORX-LITE one-channel optical receiver-F_Silkscreen.gto, ORX-LITE one-channel optical receiver-job.g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]
2026-10-16 Add the revision A documents and fabrication notes
    release/rev-A/docs holds what a person needs without KiCad: the
    schematic as a PDF (A3, colour, title block), the assembly drawing (part
    outlines with their pads and the names as printed on the board, one A4
    page) and a 3D picture of the assembled board.
    release/rev-A/README.md is the fabrication note: what each file is and
    who uses it, board size, layers, thickness, copper, mask and finish
    (ENIG recommended for the 0.5 mm-pitch ADC, HASL also works), the
    stackup, the smallest features against the board rules, the hole table
    from the drill files, assembly notes and the J1 pinout. GitHub shows it
    when the folder is opened.
    On the board only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
    [ORX-LITE one-channel optical receiver.kicad_pcb]
2026-10-17 Finish step 9: the revision A release is complete
    All nine steps are done. A final review rebuilt every release file from
    the current schematic and board and compared it with the committed one:
    the nine Gerber layers have the same shapes, the drill files the same 55
    plated and 4 non-plated holes, the placement file is identical, and the
    BOM lists the same 40 parts. The schematic checker passes all 52 parts,
    ERC reports 0 violations, and DRC 0 errors, 0 warnings, 0 unconnected
    with the board matching the schematic.
    Before an order: add manufacturer part numbers to the BOM (the ferrite
    bead's is still unconfirmed) and choose the surface finish.
2026-11-10 ORX_Lite_Receiver: add the status line and link the schematic PDF
    README: revision A is designed and its fabrication files are ready; it has
    not been ordered, built or tested yet. design_process.md links the
    schematic PDF.
2026-11-10 Add the PCB overview README and the MIT license
    One line per board with a link to its folder, as in the FPGA repo.
